Philemon-Setwaba/Embedded-Network-Performance-Monitor-for-Network-Deployments-/hardware/enclosure/images/base_dimensions.png

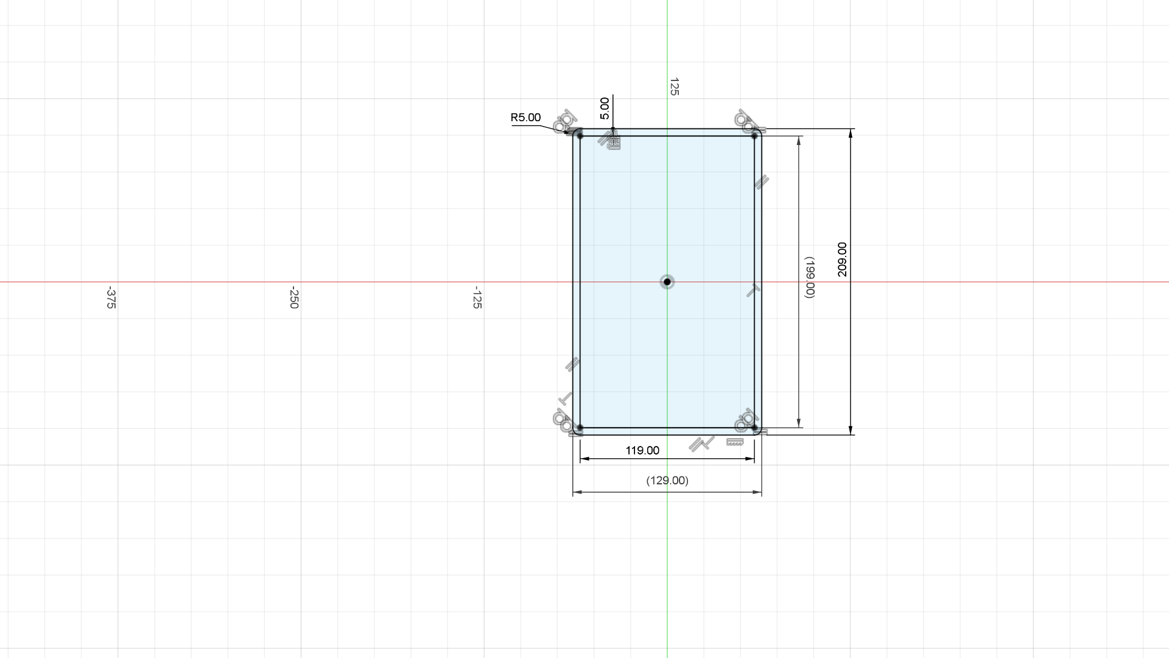
hardware/enclosure/images/base_dimensions.png
