Philemon-Setwaba/Embedded-Network-Performance-Monitor-for-Network-Deployments-/hardware/enclosure/images/base_render.png

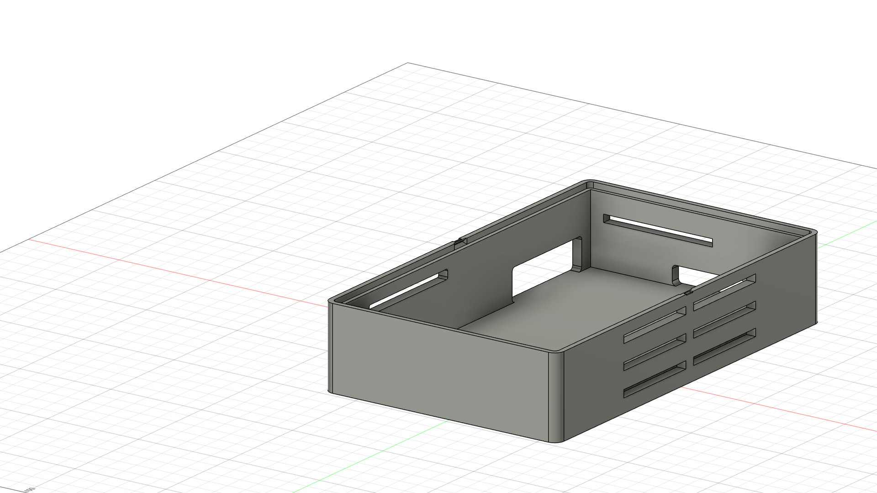
hardware/enclosure/images/base_render.png
