Philemon-Setwaba/Embedded-Network-Performance-Monitor-for-Network-Deployments-/hardware/enclosure/images/design_v0.png

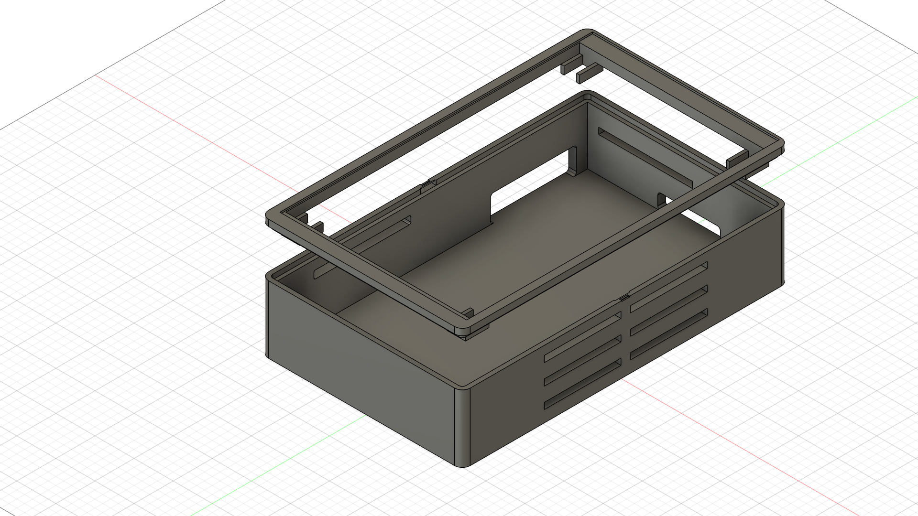
hardware/enclosure/images/design_v0.png
