Philemon-Setwaba/Embedded-Network-Performance-Monitor-for-Network-Deployments-/hardware/enclosure/images/roof_render.png

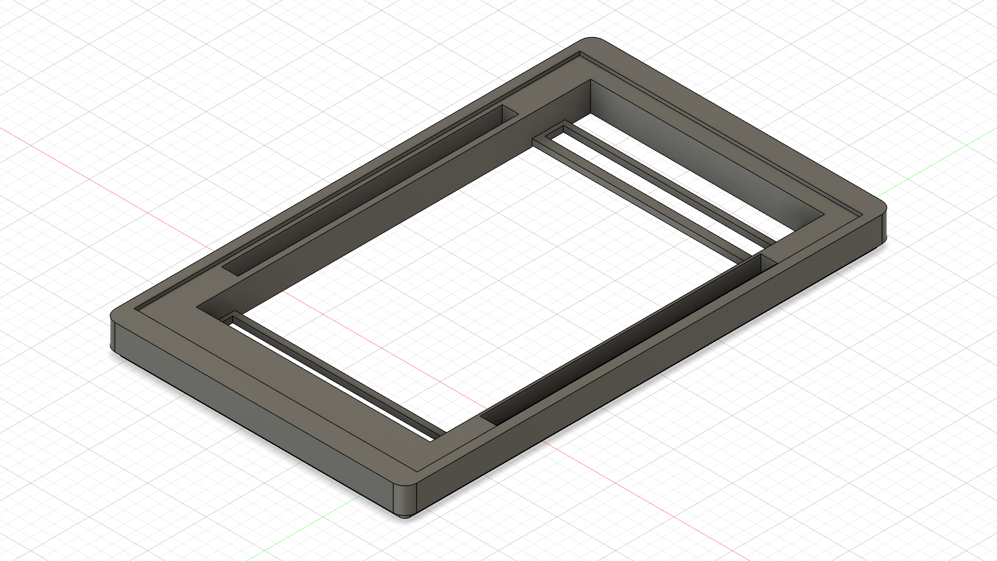
hardware/enclosure/images/roof_render.png
