Philemon-Setwaba/Embedded-Network-Performance-Monitor-for-Network-Deployments-/hardware/enclosure/images/slicer_filament.png

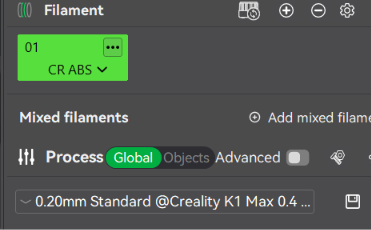
hardware/enclosure/images/slicer_filament.png
