Philemon-Setwaba/Embedded-Network-Performance-Monitor-for-Network-Deployments-/hardware/enclosure/stl/enclosure_roof.stl

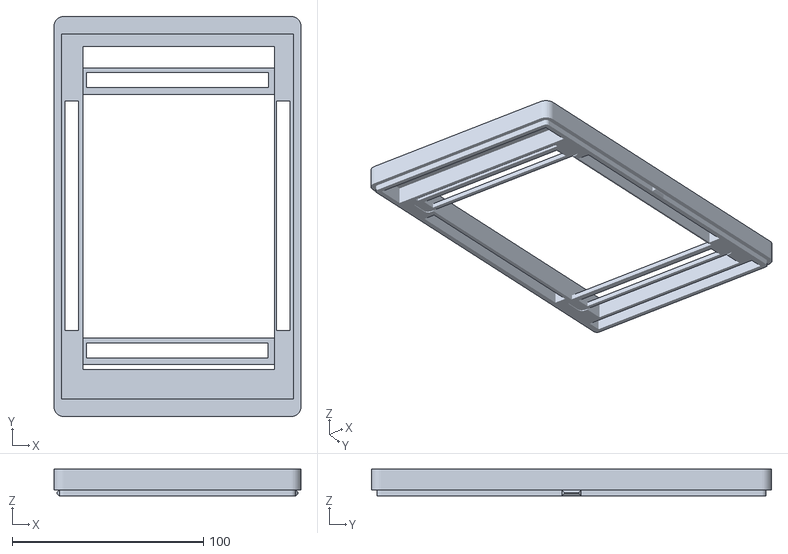
[picture p19: CAD file, 2026-11-01]
hardware/enclosure/stl/enclosure_roof.stl
129.0 x 209.0 x 14.0
