Philemon-Setwaba/Embedded-Network-Performance-Monitor-for-Network-Deployments-/hardware/enclosure/stl/enclosure_print_plate.stl

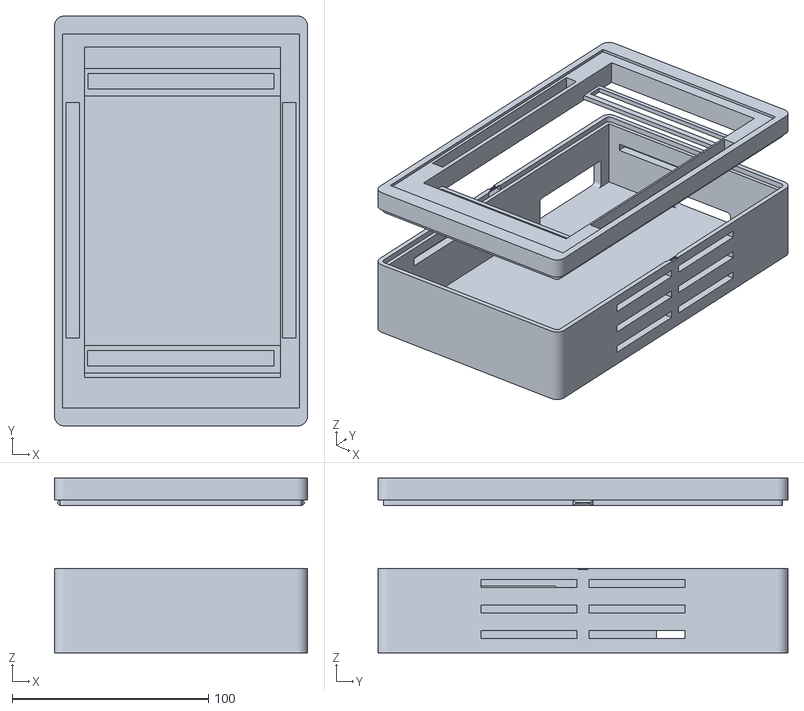
[picture p20: CAD file, 2026-11-01]
hardware/enclosure/stl/enclosure_print_plate.stl
129.0 x 209.0 x 89.0
