Philemon-Setwaba/Embedded-Network-Performance-Monitor-for-Network-Deployments-/hardware/enclosure/stl/enclosure_base.stl

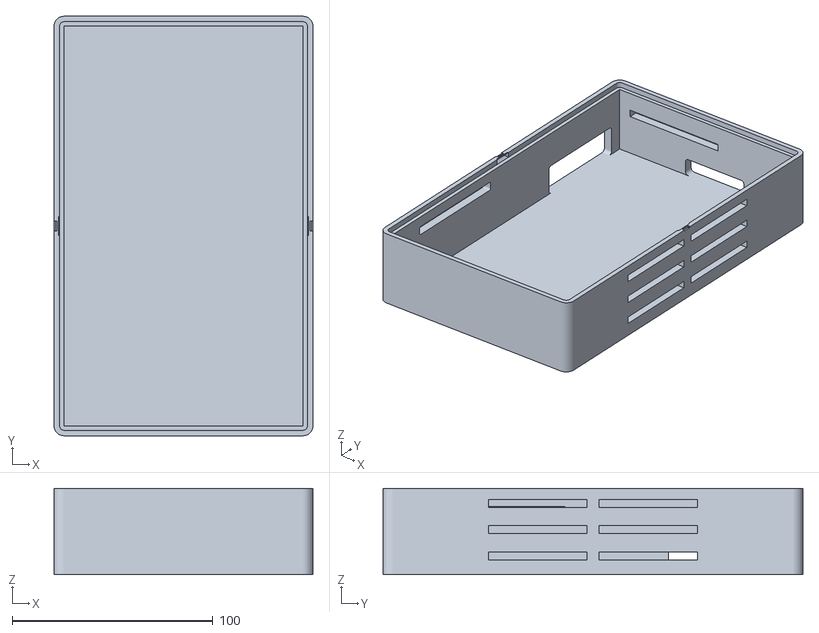
[picture p21: CAD file, 2026-11-01]
hardware/enclosure/stl/enclosure_base.stl
129.0 x 209.0 x 43.0
