Philemon-Setwaba/Embedded-Network-Performance-Monitor-for-Network-Deployments-/(list of files, cad)

Other CAD files:
hardware/enclosure/enclosure.f3d
