Philemon-Setwaba/Embedded-Network-Performance-Monitor-for-Network-Deployments-/tests/test7_normal_operation/t7_iperf.pdf

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

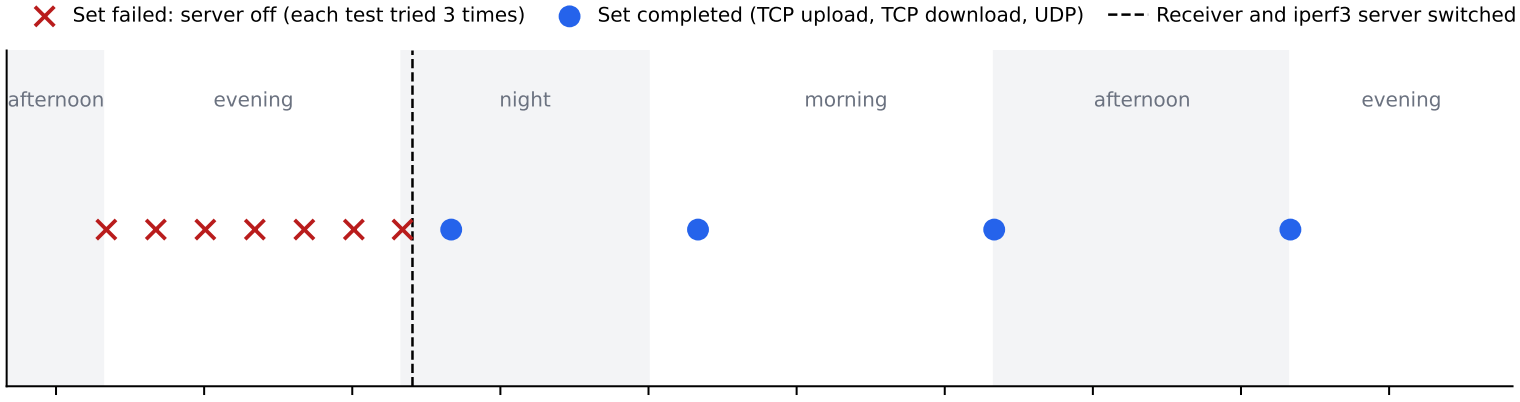
[picture p22: figure]
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
