Philemon-Setwaba/Embedded-Network-Performance-Monitor-for-Network-Deployments-/hardware/enclosure/images/printed_2.jpeg

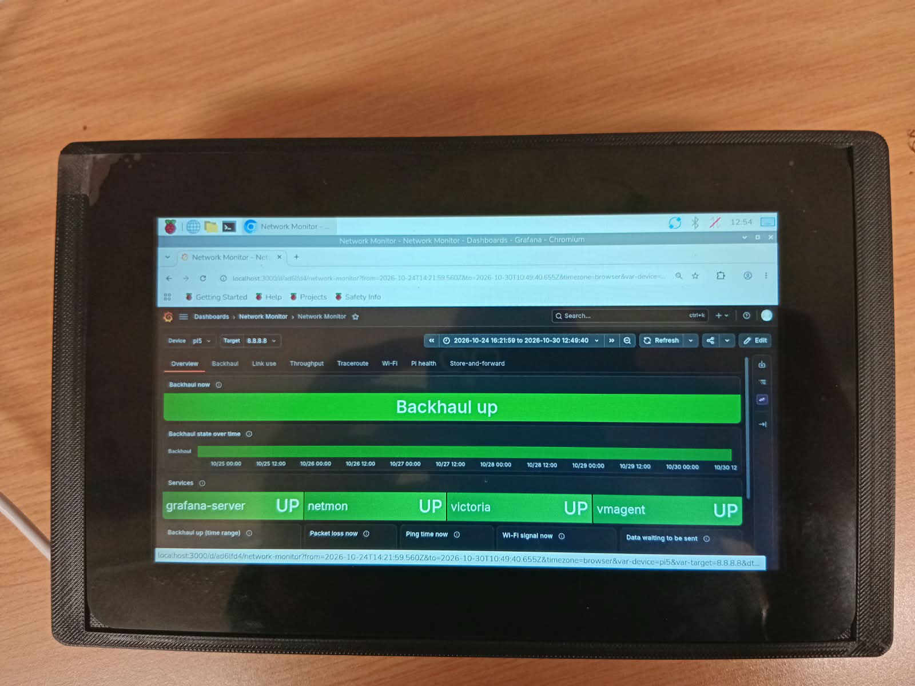
hardware/enclosure/images/printed_2.jpeg
