Philemon-Setwaba/Embedded-Network-Performance-Monitor-for-Network-Deployments-/hardware/enclosure/images/slicer_printer.png

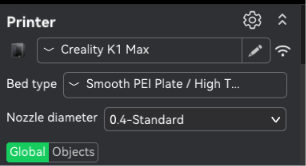
hardware/enclosure/images/slicer_printer.png
