Philemon-Setwaba/Embedded-Network-Performance-Monitor-for-Network-Deployments-/tests/test7_normal_operation/t7_iperf.png

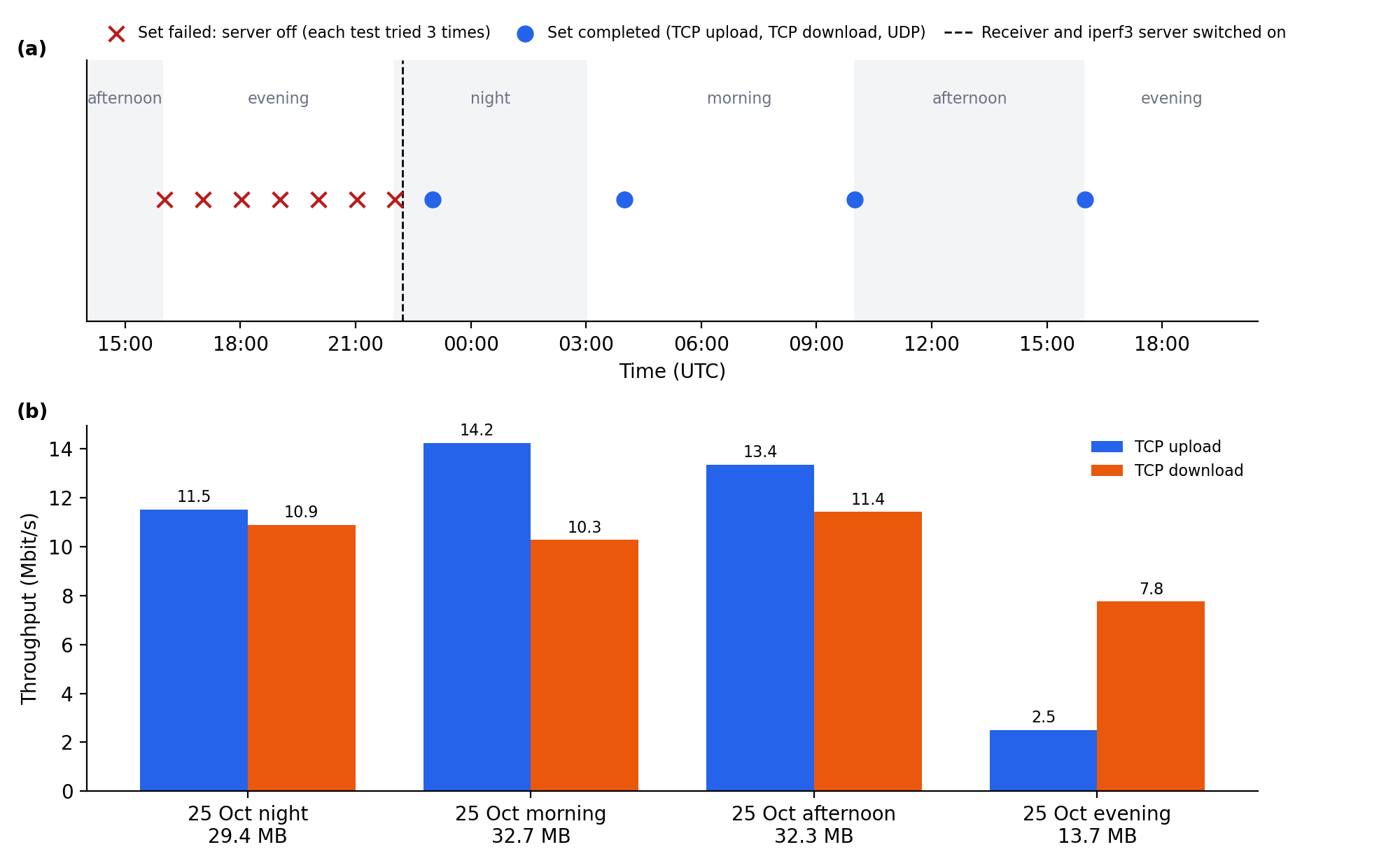
tests/test7_normal_operation/t7_iperf.png
