Philemon-Setwaba/Embedded-Network-Performance-Monitor-for-Network-Deployments-/tests/test1_packet_loss/figures/t1_backhaul_state.pdf

0 | 10 | 20 | 30 | 40 | 50 | 60 | 70 | 80

### Time since start of test (min)

0 % | 10 % | 30 % | 50 % | 70 % | 90 % | 100 % | 0 %
1 2 3 | 4 | 5 | Key
Backhaul up
Backhaul down
# | Applied loss | Down at (min) | Up at (min) | Down for (s) | Declared down because | Declared up because

1 | 90 % | 50.90 | 51.25 | 21 | 0/5 pings + TCP timeout, 2 checks in a row | 0/5 pings, but TCP connected
2 | 90 % | 51.75 | 51.94 | 11 | 0/5 pings + TCP timeout, 2 checks in a row | 1/5 pings replied
3 | 90 % | 54.98 | 55.48 | 30 | 0/5 pings + TCP timeout, 2 checks in a row | 1/5 pings replied
4 | 90 % | 59.33 | 59.75 | 25 | 0/5 pings + TCP timeout, 2 checks in a row | 0/5 pings, but TCP connected
5 | 100 % | 60.26 | 70.02 | 586 | 0/5 pings + TCP timeout, 2 checks in a row | 0/5 pings, but TCP connected

Down 5 times, 674 s in total; up for the rest of the 80 min.
Times and reasons are the state changes logged by the monitor (journal), cross-checked with the stored state samples.
