Philemon-Setwaba/Embedded-Network-Performance-Monitor-for-Network-Deployments-/tests/test2_delay/figures/t2_delay_measured_vs_applied.pdf

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

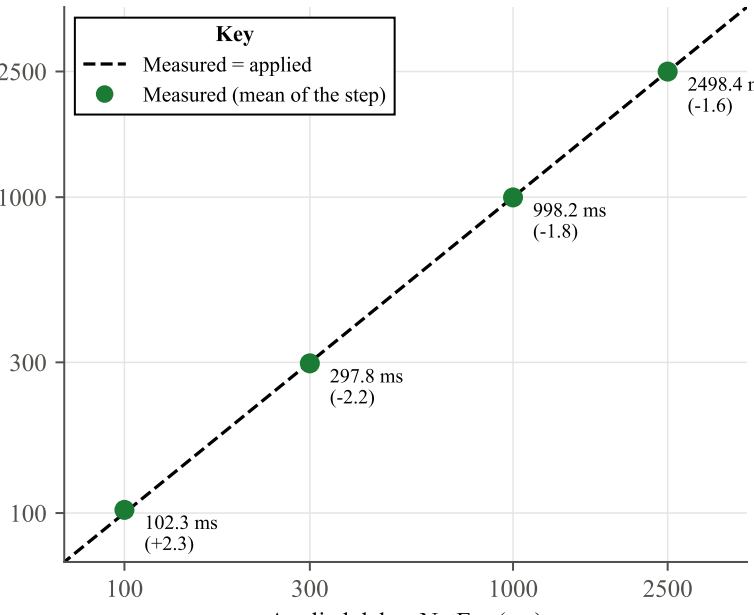
[picture p29: figure]
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
