Philemon-Setwaba/Embedded-Network-Performance-Monitor-for-Network-Deployments-/tests/test1_packet_loss/figures/t1_results_table.csv

Step | Time (min) | Applied loss | Checks | Pings | Measured loss | 95 % range | Mean RTT (ms) | Checks with all 5 lost (%) | Time reported down (%) | TCP check: connected / failed | SNMP no reply
0 (baseline) | 0–10 | 0 % | 55 | 275 | 0.4 % | 0.1–2.0 % | 77.5 | 0.0 % | 0.0 % | 0 / 0 | 0.0 %
1 | 10–20 | 10 % | 57 | 285 | 7.4 % | 4.9–11.0 % | 69.7 | 0.0 % | 0.0 % | 0 / 0 | 7.0 %
2 | 20–30 | 30 % | 57 | 285 | 27.0 % | 22.2–32.5 % | 72.4 | 0.0 % | 0.0 % | 0 / 0 | 26.3 %
3 | 30–40 | 50 % | 57 | 285 | 50.2 % | 44.4–55.9 % | 69.4 | 5.3 % | 0.0 % | 3 / 0 | 50.9 %
4 | 40–50 | 70 % | 57 | 285 | 62.8 % | 57.1–68.2 % | 78.3 | 8.8 % | 0.0 % | 3 / 2 | 64.9 %
5 | 50–60 | 90 % | 56 | 280 | 91.1 % | 87.2–93.9 % | 70.1 | 62.5 % | 14.3 % | 14 / 21 | 91.2 %
6 | 60–70 | 100 % | 57 | 285 | 100.0 % | 98.7–100.0 % | – | 100.0 % | 98.2 % | 1 / 57 | 100.0 %
7 (recovery) | 70–80 | 0 % | 57 | 285 | 0.7 % | 0.2–2.5 % | 84.9 | 0.0 % | 0.0 % | 0 / 0 | 0.0 %
