Philemon-Setwaba/Embedded-Network-Performance-Monitor-for-Network-Deployments-/tests/test2_delay/figures/t2_results_table.csv

Step | Time (min) | NetEm delay (ms) | Checks | Mean RTT (ms) | Added delay (ms) | Error (ms) | Variation per check, median (IQR) (ms) | Ping loss (%) | Time reported down | SNMP no reply
0 | 0-10 | none | 55 | 48.7 | 0.0 | 0.0 | 5.8 | 0.0 | 0.0 | 0.0
1 | 10-20 | 100 ms | 57 | 151.0 | 102.3 | 2.3 | 5.9 | 0.0 | 0.0 | 0.0
2 | 20-30 | 100 ± 10 ms | 57 | 149.1 | 100.4 | 0.4 | 8.0 | 0.0 | 0.0 | 0.0
3 | 30-40 | 100 ± 25 ms | 57 | 151.7 | 103.0 | 3.0 | 16.4 | 0.35 | 0.0 | 0.0
4 | 40-50 | 100 ± 50 ms | 57 | 152.6 | 103.9 | 3.9 | 28.7 | 0.0 | 0.0 | 0.0
5 | 50-60 | 300 ms | 57 | 346.5 | 297.8 | -2.2 | 4.4 | 0.0 | 0.0 | 0.0
6 | 60-70 | 1000 ms | 57 | 1046.9 | 998.2 | -1.8 | 5.0 | 0.0 | 0.0 | 0.0
7 | 70-80 | 2500 ms | 57 | 2547.1 | 2498.4 | -1.6 | 5.0 | 0.7 | 0.0 | 0.0
8 | 80-90 | none | 57 | 47.8 | -0.9 | -0.9 | 4.8 | 1.75 | 0.0 | 0.0
