Philemon-Setwaba/Embedded-Network-Performance-Monitor-for-Network-Deployments-/tests/test3_receiver_outage/T3/test3_outage_20261022T0423Z.csv

phase | time_utc | pending_bytes | disk_bytes | bytes_sent_total | rate_limit_reached_total | dropped | note
start | 2026-10-22T04:24:08Z |  |  |  |  |  | systemctl start vmagent
start | 2026-10-22T04:24:08Z | 0 | 57 | 0 | 0 | 0 | systemctl start netmon - outage begins (receiver off)
outage | 2026-10-22T04:25:08Z | 0 | 14848 | 0 | 0 | 0
outage | 2026-10-22T04:26:14Z | 0 | 31730 | 0 | 0 | 0
outage | 2026-10-22T04:27:19Z | 0 | 47433 | 0 | 0 | 0
outage | 2026-10-22T04:28:24Z | 0 | 64252 | 0 | 0 | 0
outage | 2026-10-22T04:29:29Z | 0 | 80165 | 0 | 0 | 0
outage | 2026-10-22T04:30:34Z | 0 | 98186 | 0 | 0 | 0
outage | 2026-10-22T04:31:39Z | 0 | 115283 | 0 | 0 | 0
outage | 2026-10-22T04:32:44Z | 0 | 133393 | 0 | 0 | 0
outage | 2026-10-22T04:33:49Z | 0 | 150400 | 0 | 0 | 0
outage | 2026-10-22T04:34:54Z | 0 | 168494 | 0 | 0 | 0
outage | 2026-10-22T04:35:59Z | 0 | 185547 | 0 | 0 | 0
outage | 2026-10-22T04:37:04Z | 0 | 203627 | 0 | 0 | 0
outage | 2026-10-22T04:38:09Z | 0 | 220726 | 0 | 0 | 0
outage | 2026-10-22T04:39:15Z | 0 | 238752 | 0 | 0 | 0
outage | 2026-10-22T04:40:20Z | 0 | 256440 | 0 | 0 | 0
outage | 2026-10-22T04:41:25Z | 0 | 274097 | 0 | 0 | 0
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
