Philemon-Setwaba/Embedded-Network-Performance-Monitor-for-Network-Deployments-/tests/test5_backhaul_outage/T6/test6_backhaul_outage_20261023T1934Z.csv

phase | time_utc | internet | router | receiver | pending_bytes | disk_bytes | bytes_sent_total | dropped | note
start | 2026-10-23T19:34:54Z |  |  |  |  |  |  |  | systemctl start vmagent
start | 2026-10-23T19:34:55Z | UP | UP | UP | 0 | 57 | 0 | 0 | systemctl start netmon - test begins
ph0_baseline | 2026-10-23T19:34:55Z | UP | UP | UP | 0 | 57 | 0 | 0 | internet_UP
ph0_baseline | 2026-10-23T19:35:05Z | UP | UP | UP | 0 | 57 | 4002 | 0
ph0_baseline | 2026-10-23T19:35:15Z | UP | UP | UP | 0 | 57 | 7335 | 0
ph0_baseline | 2026-10-23T19:35:25Z | UP | UP | UP | 0 | 57 | 9025 | 0
ph0_baseline | 2026-10-23T19:35:35Z | UP | UP | UP | 0 | 57 | 11645 | 0
ph0_baseline | 2026-10-23T19:35:45Z | UP | UP | UP | 0 | 57 | 14554 | 0
ph0_baseline | 2026-10-23T19:35:55Z | UP | UP | UP | 0 | 57 | 17871 | 0
ph0_baseline | 2026-10-23T19:36:05Z | UP | UP | UP | 0 | 57 | 19678 | 0
ph0_baseline | 2026-10-23T19:36:15Z | UP | UP | UP | 0 | 57 | 22448 | 0
ph0_baseline | 2026-10-23T19:36:25Z | UP | UP | UP | 0 | 57 | 26434 | 0
ph0_baseline | 2026-10-23T19:36:35Z | UP | UP | UP | 0 | 57 | 28388 | 0
ph0_baseline | 2026-10-23T19:36:45Z | UP | UP | UP | 0 | 57 | 30788 | 0
ph0_baseline | 2026-10-23T19:36:55Z | UP | UP | UP | 0 | 57 | 33400 | 0
ph0_baseline | 2026-10-23T19:37:05Z | UP | UP | UP | 0 | 57 | 36524 | 0
ph0_baseline | 2026-10-23T19:37:15Z | UP | UP | UP | 0 | 57 | 39556 | 0
ph0_baseline | 2026-10-23T19:37:25Z | UP | UP | UP | 0 | 57 | 41206 | 0
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
ph4_recovery2 | 2026-10-23T21:33:31Z | UP | UP | UP | 0 | 1000924 | 1915160 | 0
ph4_recovery2 | 2026-10-23T21:33:42Z | UP | UP | UP | 0 | 1000924 | 1917805 | 0
ph4_recovery2 | 2026-10-23T21:33:51Z | UP | UP | UP | 0 | 1000924 | 1920431 | 0
ph4_recovery2 | 2026-10-23T21:34:01Z | UP | UP | UP | 0 | 1000924 | 1923079 | 0
ph4_recovery2 | 2026-10-23T21:34:12Z | UP | UP | UP | 0 | 1000924 | 1925697 | 0
ph4_recovery2 | 2026-10-23T21:34:21Z | UP | UP | UP | 0 | 1000924 | 1928347 | 0
ph4_recovery2 | 2026-10-23T21:34:31Z | UP | UP | UP | 0 | 1000924 | 1930992 | 0
ph4_recovery2 | 2026-10-23T21:34:41Z | UP | UP | UP | 0 | 1000924 | 1933634 | 0
ph4_recovery2 | 2026-10-23T21:34:52Z | UP | UP | UP | 0 | 1000924 | 1936278 | 0
end | 2026-10-23T21:34:54Z | UP | UP | UP | 0 | 1000924 | 1936878 | 0 | test time over
cleanup | 2026-10-23T21:34:54Z | UP | UP | UP | 0 | 1000924 | 1936878 | 0 | systemctl stop netmon
drain | 2026-10-23T21:34:55Z | UP | UP | UP | 0 | 1000924 | 1936878 | 0 | waited_s=0
cleanup | 2026-10-23T21:34:55Z |  |  |  |  |  |  |  | systemctl stop vmagent
