Philemon-Setwaba/Embedded-Network-Performance-Monitor-for-Network-Deployments-/tests/test1_packet_loss/figures/t1_loss_timeline.png

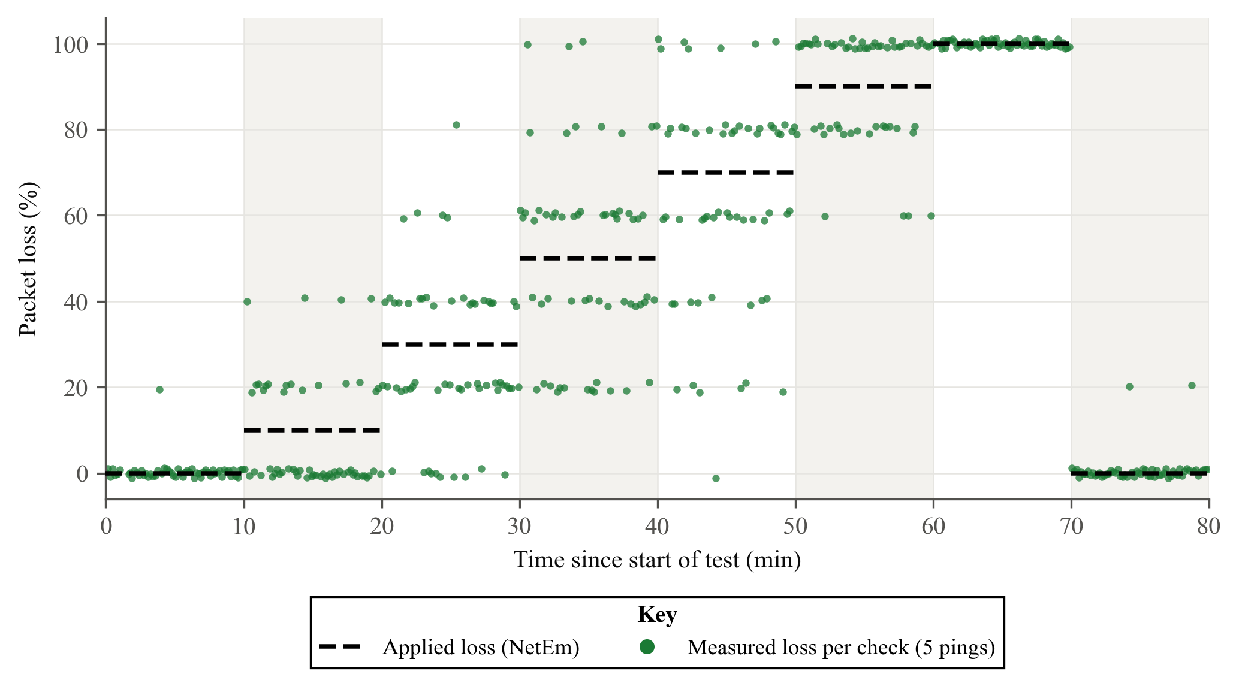
tests/test1_packet_loss/figures/t1_loss_timeline.png
