Philemon-Setwaba/Embedded-Network-Performance-Monitor-for-Network-Deployments-/tests/test1_packet_loss/Proof that it try after 1h.png

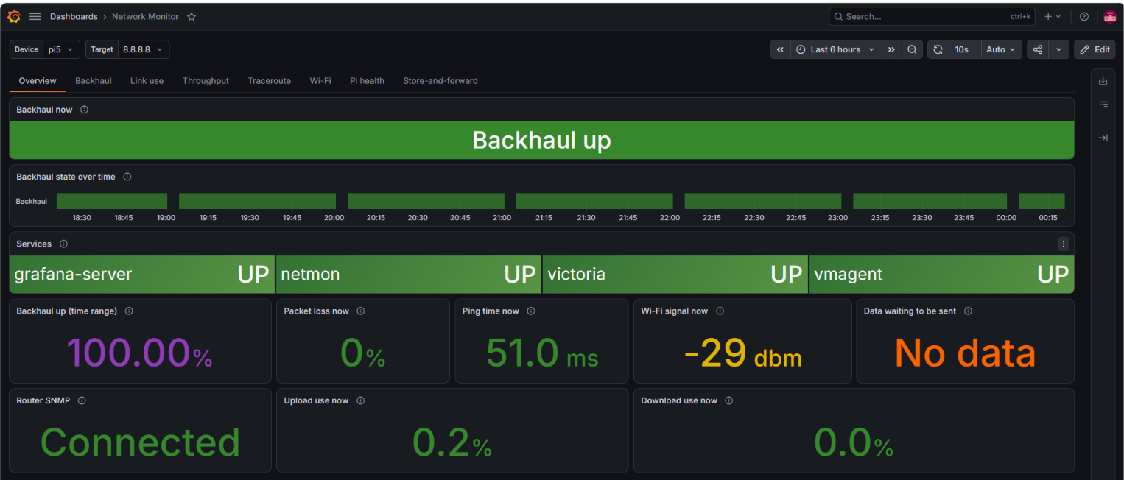
tests/test1_packet_loss/Proof that it try after 1h.png
