Philemon-Setwaba/Embedded-Network-Performance-Monitor-for-Network-Deployments-/tests/test1_packet_loss/T2.png

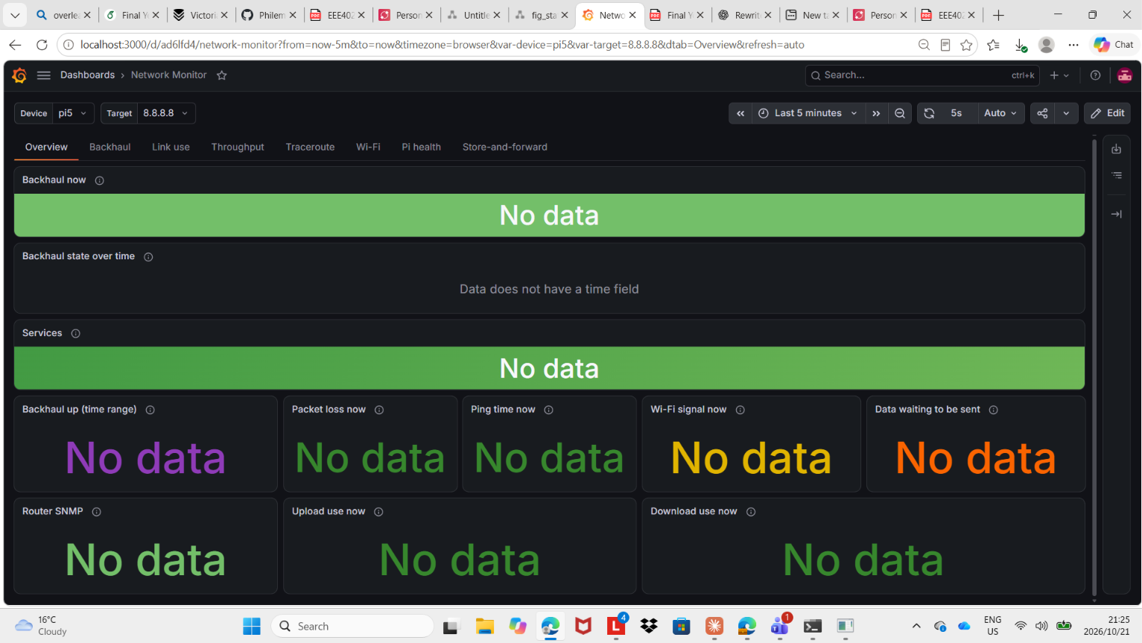
tests/test1_packet_loss/T2.png
