Philemon-Setwaba/Embedded-Network-Performance-Monitor-for-Network-Deployments-/tests/test2_delay/figures/t2_variation_measured_vs_applied.png

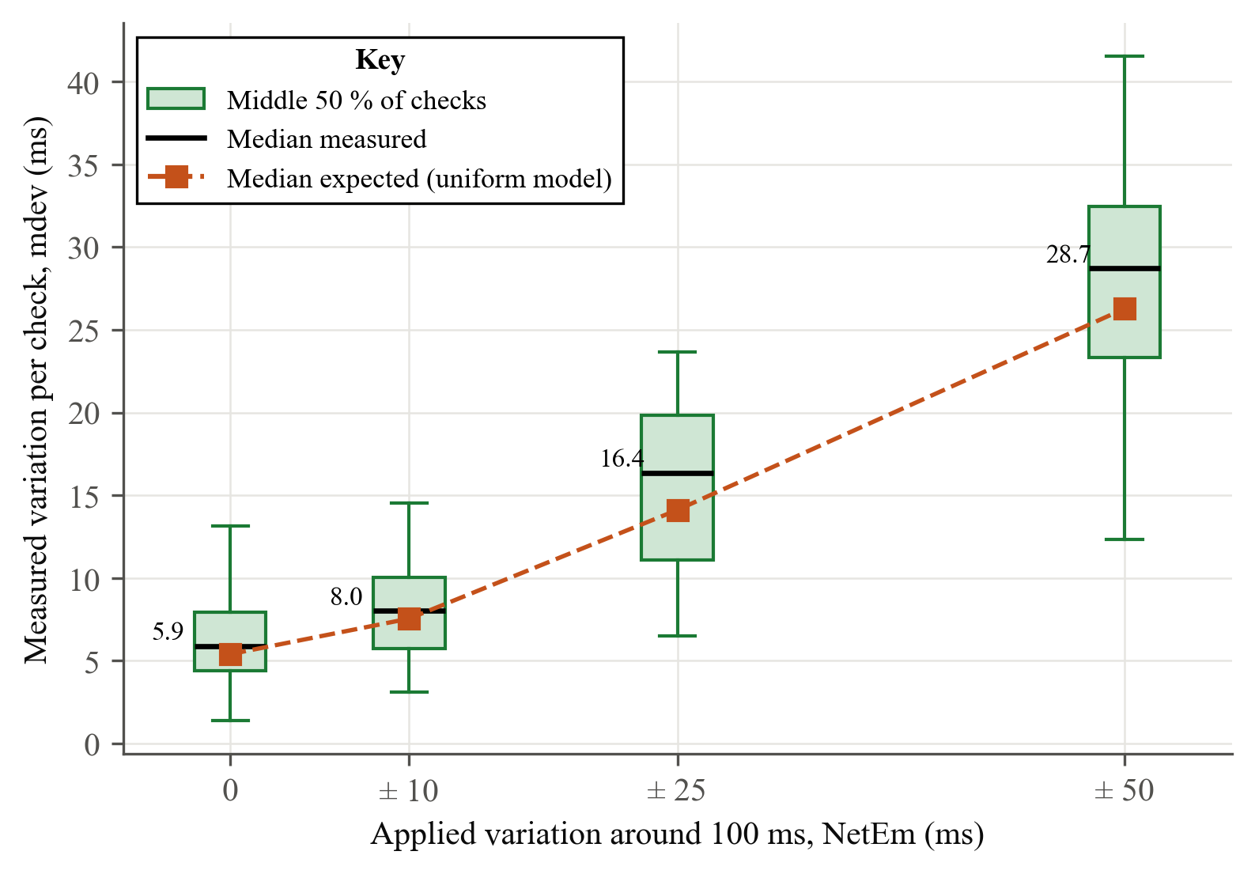
tests/test2_delay/figures/t2_variation_measured_vs_applied.png
