Philemon-Setwaba/Embedded-Network-Performance-Monitor-for-Network-Deployments-/tests/test3_receiver_outage/figures/t3_catchup.png

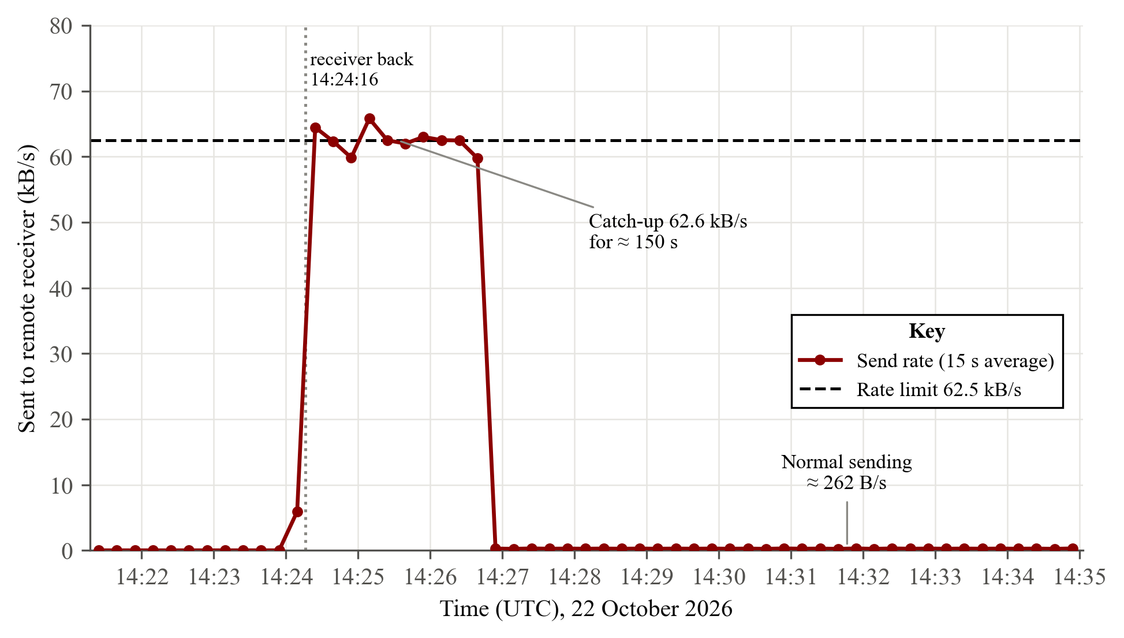
tests/test3_receiver_outage/figures/t3_catchup.png
