Philemon-Setwaba/Embedded-Network-Performance-Monitor-for-Network-Deployments-/tests/test4_snmp/first_attempt/t4_comparison_bar.png

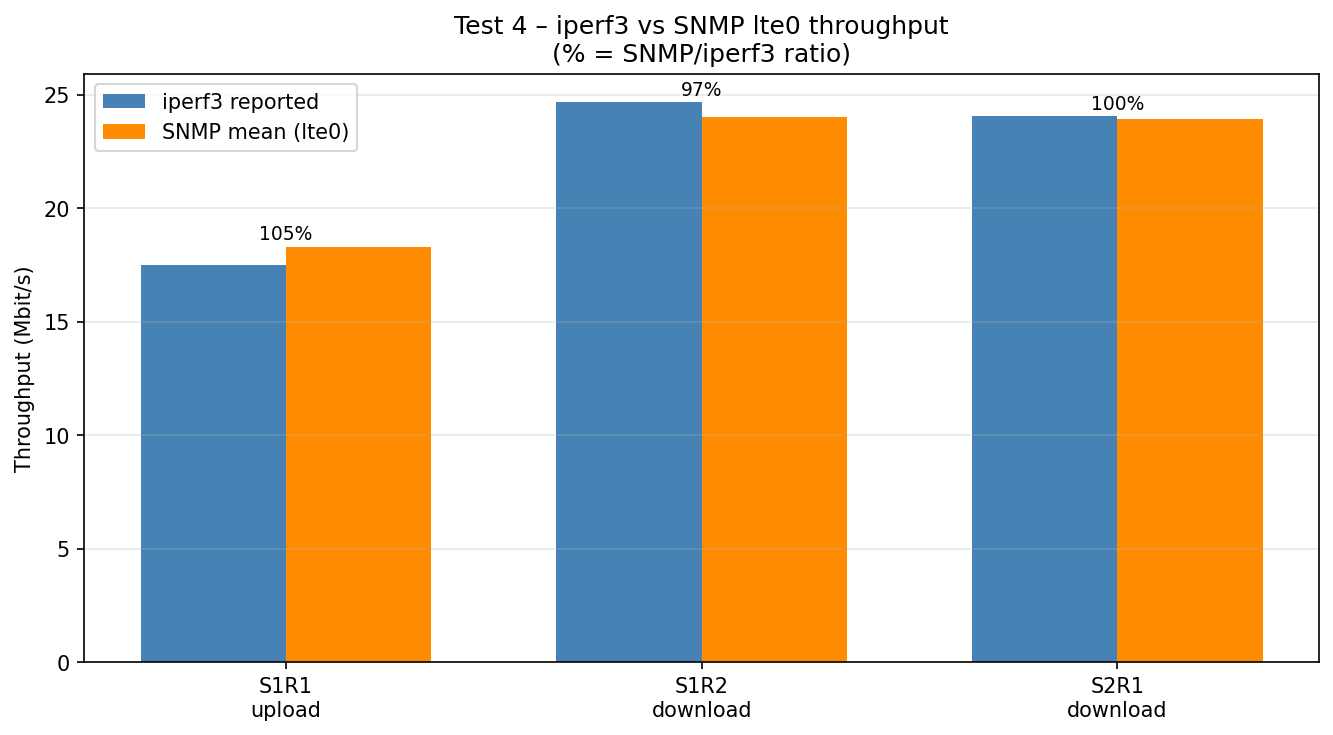
tests/test4_snmp/first_attempt/t4_comparison_bar.png
