Philemon-Setwaba/Embedded-Network-Performance-Monitor-for-Network-Deployments-/tests/test4_snmp/first_attempt/t4_snmp_validation.png

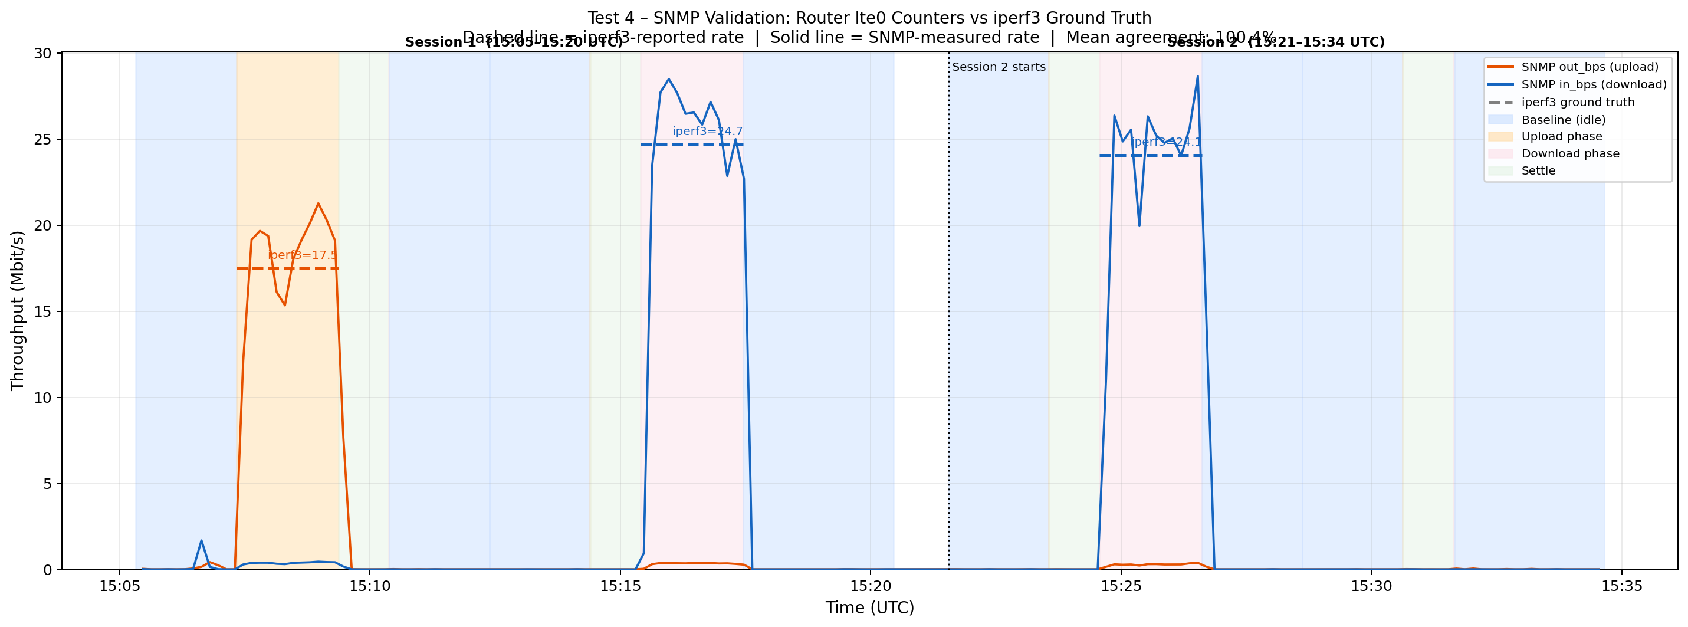
tests/test4_snmp/first_attempt/t4_snmp_validation.png
