Philemon-Setwaba/Embedded-Network-Performance-Monitor-for-Network-Deployments-/tests/test4_snmp/t4_fig1_timeline.png

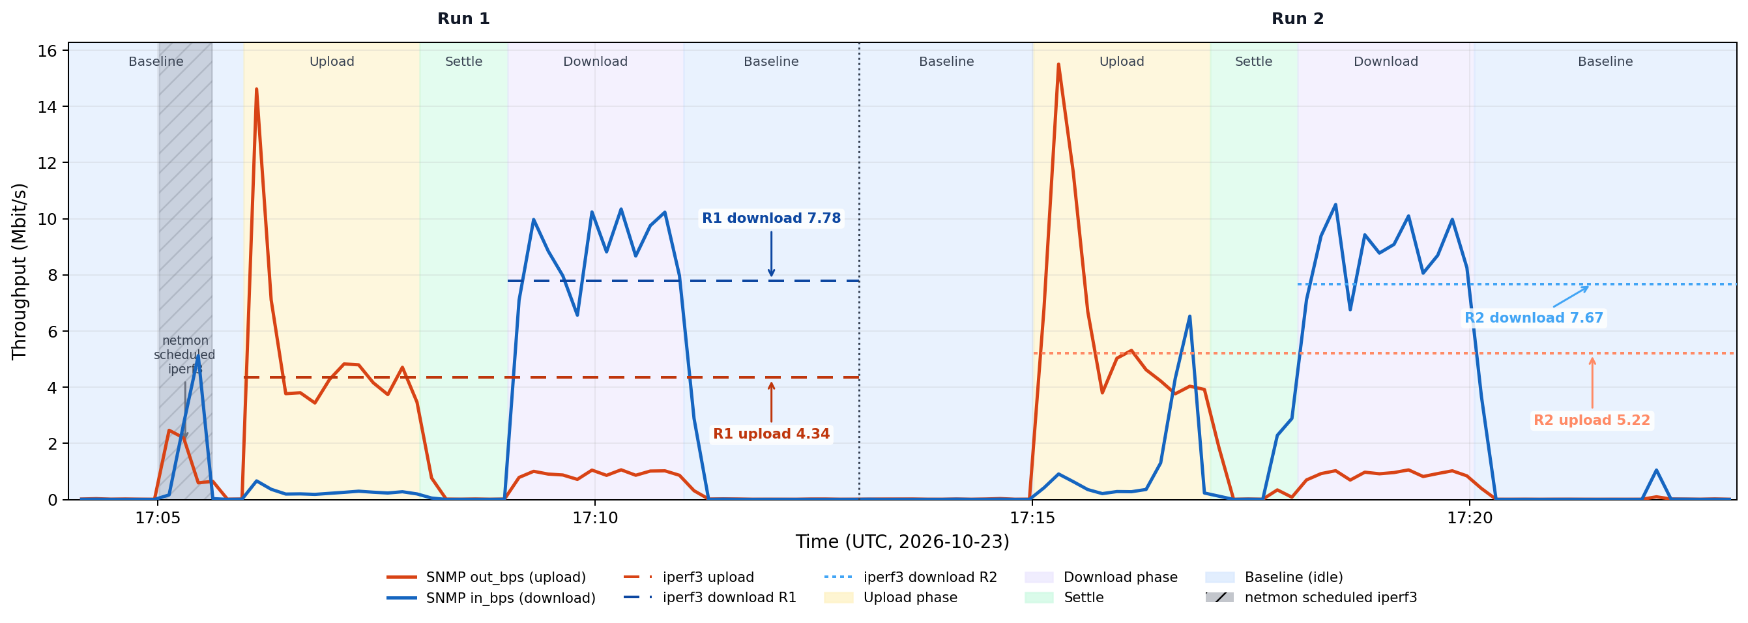
tests/test4_snmp/t4_fig1_timeline.png
