Philemon-Setwaba/Embedded-Network-Performance-Monitor-for-Network-Deployments-/tests/test4_snmp/t4_fig2_comparison.png

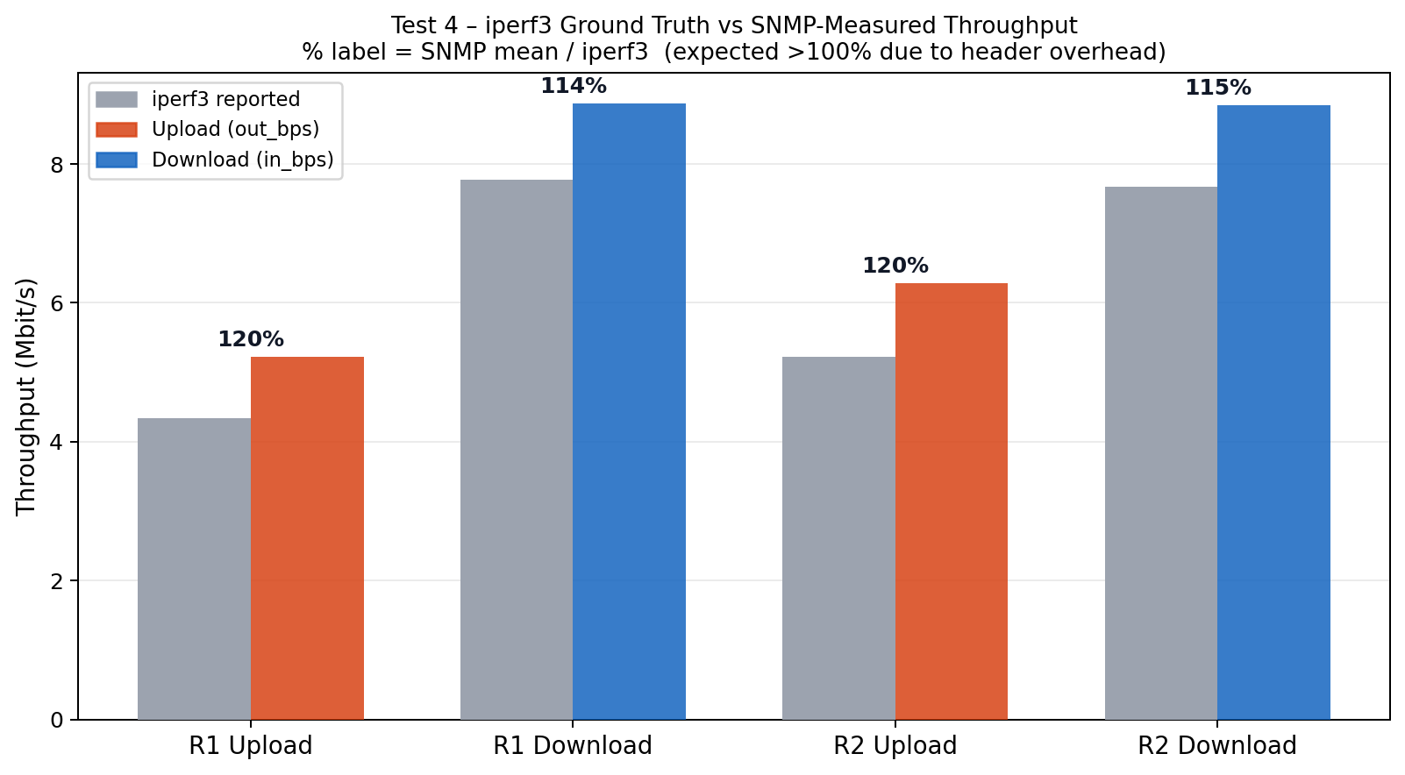
tests/test4_snmp/t4_fig2_comparison.png
