Philemon-Setwaba/Embedded-Network-Performance-Monitor-for-Network-Deployments-/tests/test5_backhaul_outage/t5_backhaul_outage.png

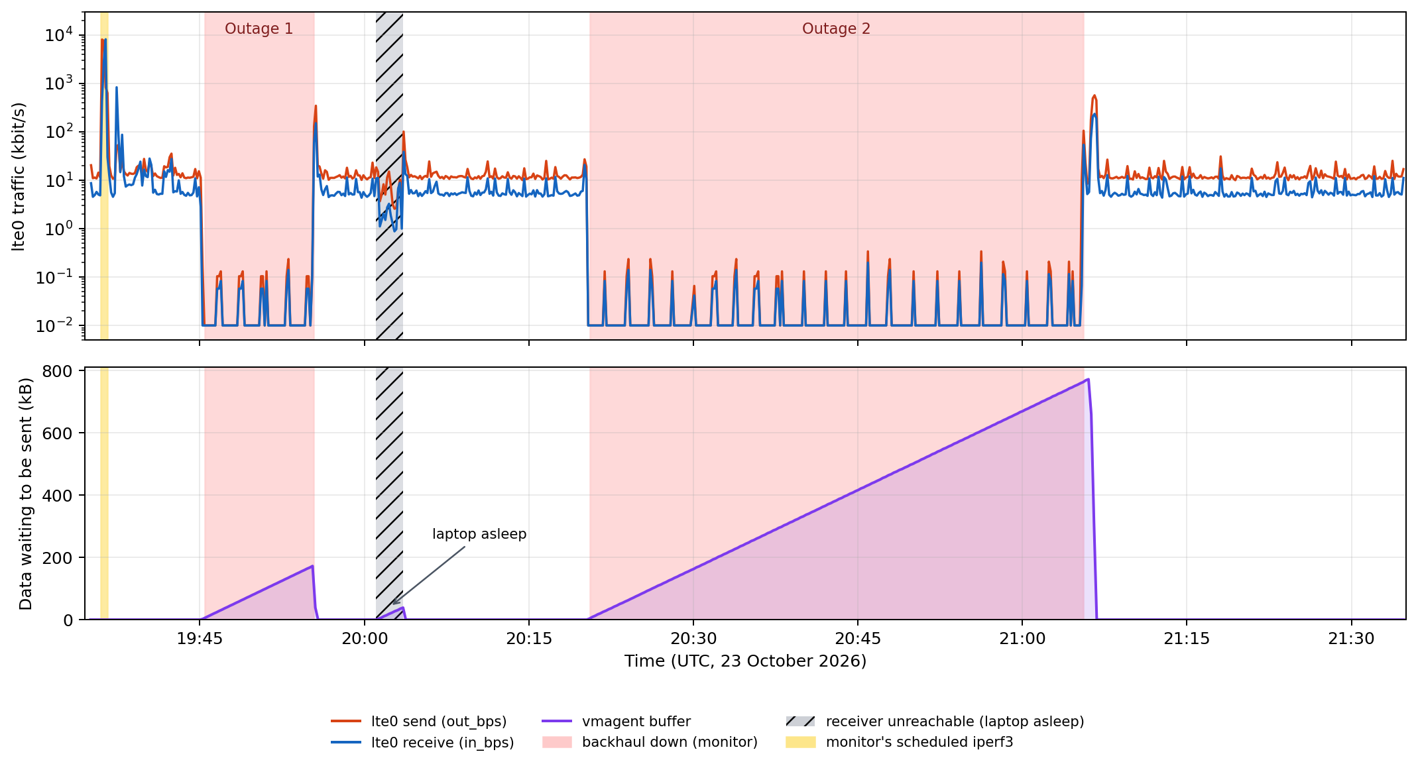
tests/test5_backhaul_outage/t5_backhaul_outage.png
