Philemon-Setwaba/Embedded-Network-Performance-Monitor-for-Network-Deployments-/tests/test6_power_cut/t6_resources.png

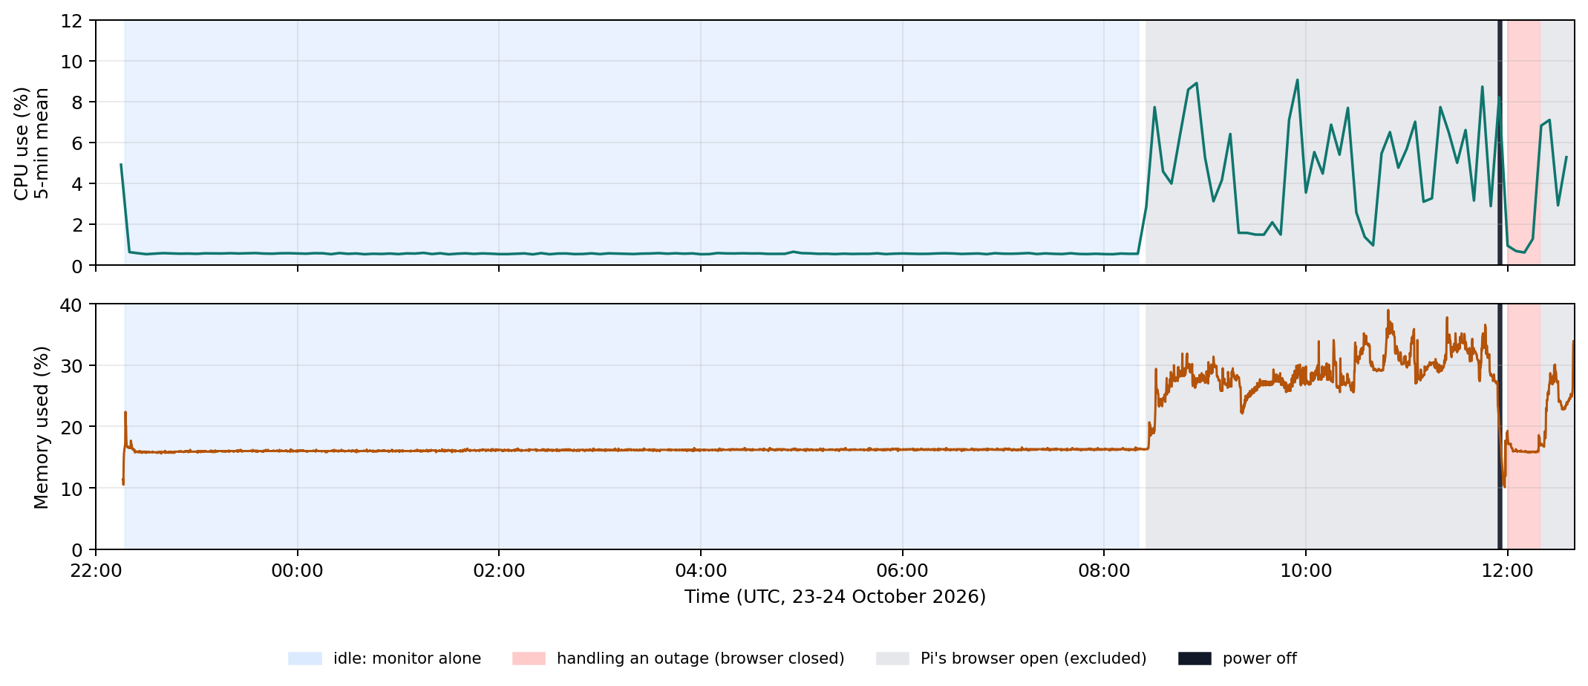
tests/test6_power_cut/t6_resources.png
