Philemon-Setwaba/Embedded-Network-Performance-Monitor-for-Network-Deployments-/tests/test6_power_cut/T7/idle/screenshots/2026traceroute.png

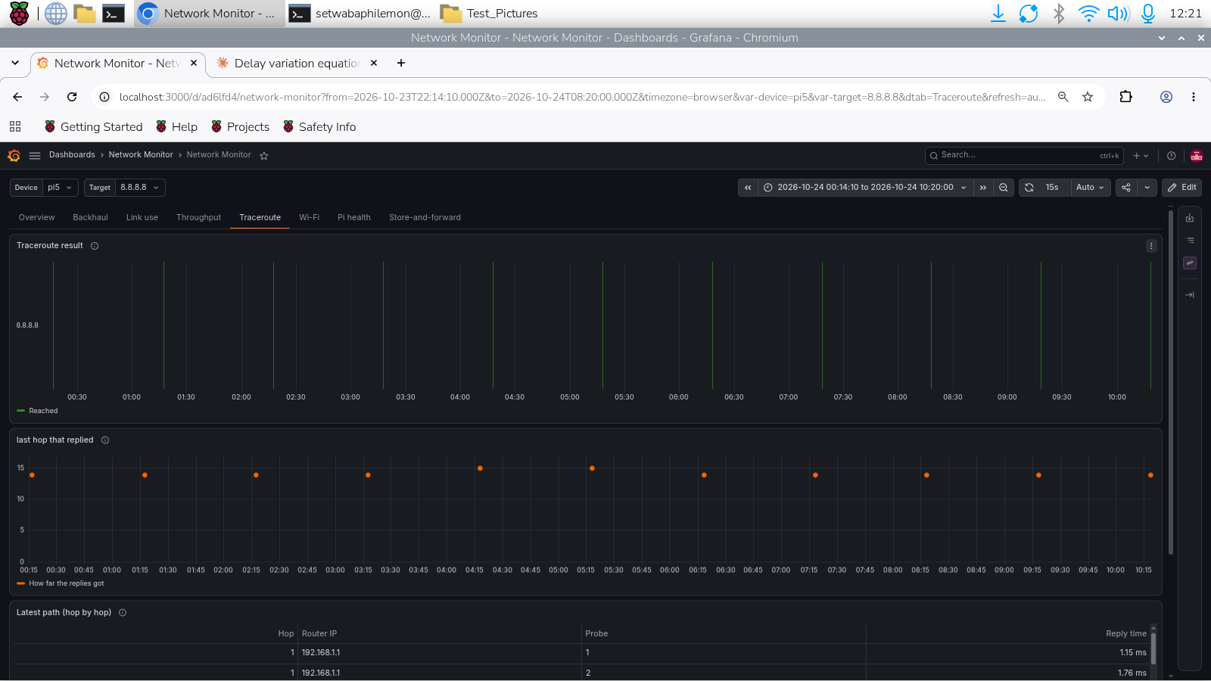
tests/test6_power_cut/T7/idle/screenshots/2026traceroute.png
