Philemon-Setwaba/Embedded-Network-Performance-Monitor-for-Network-Deployments-/tests/test4_snmp/t4_fig1_timeline.pdf

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

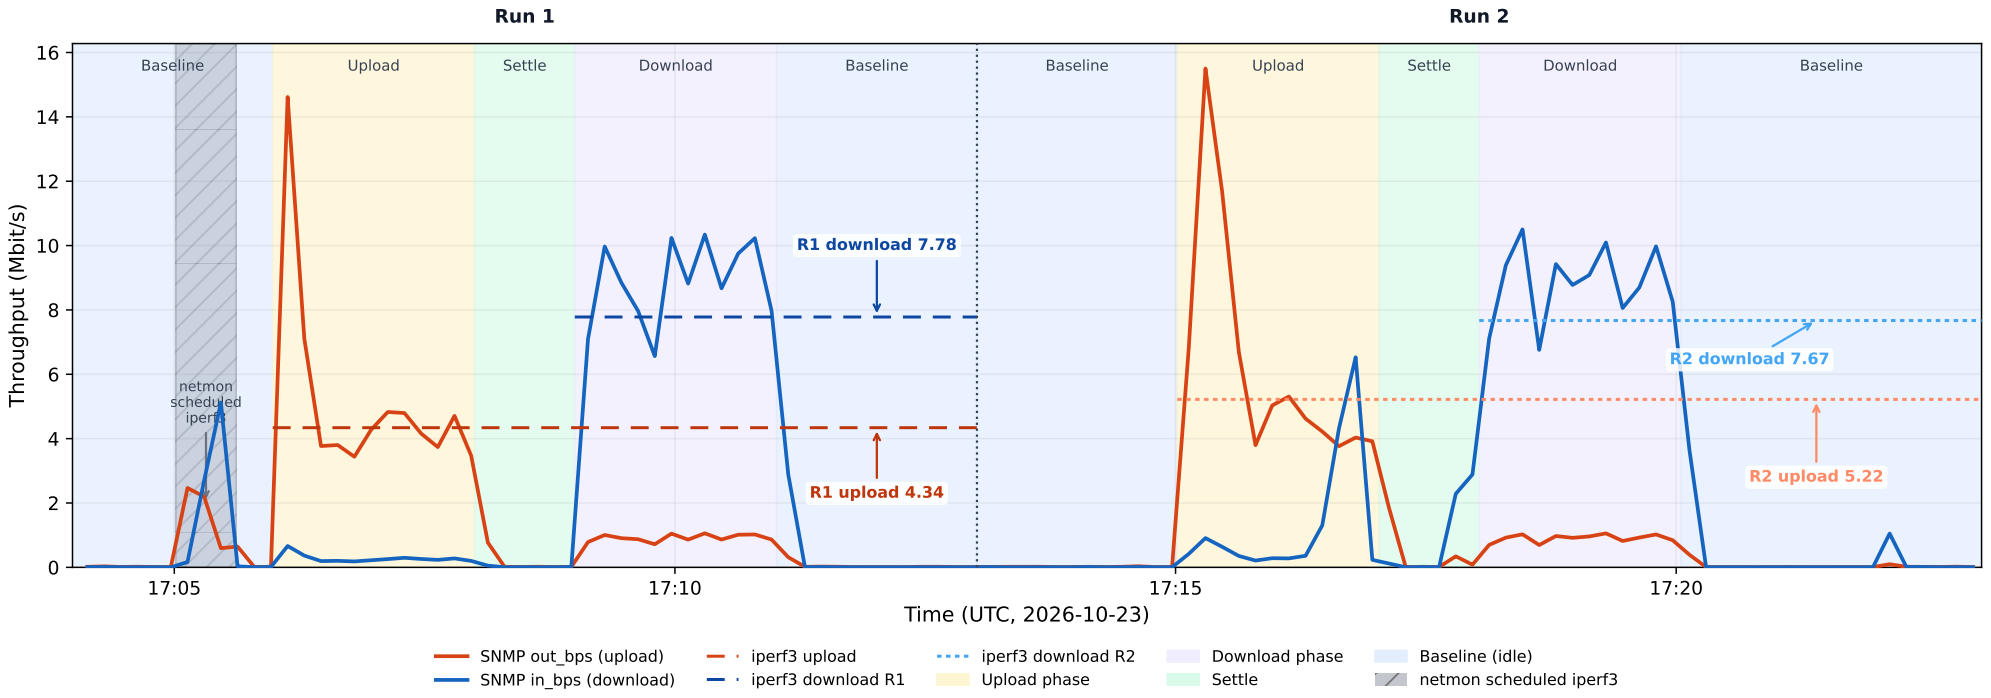
[picture p58: page 1]
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
