Philemon-Setwaba/Embedded-Network-Performance-Monitor-for-Network-Deployments-/tests/test5_backhaul_outage/t5_backhaul_outage.pdf

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

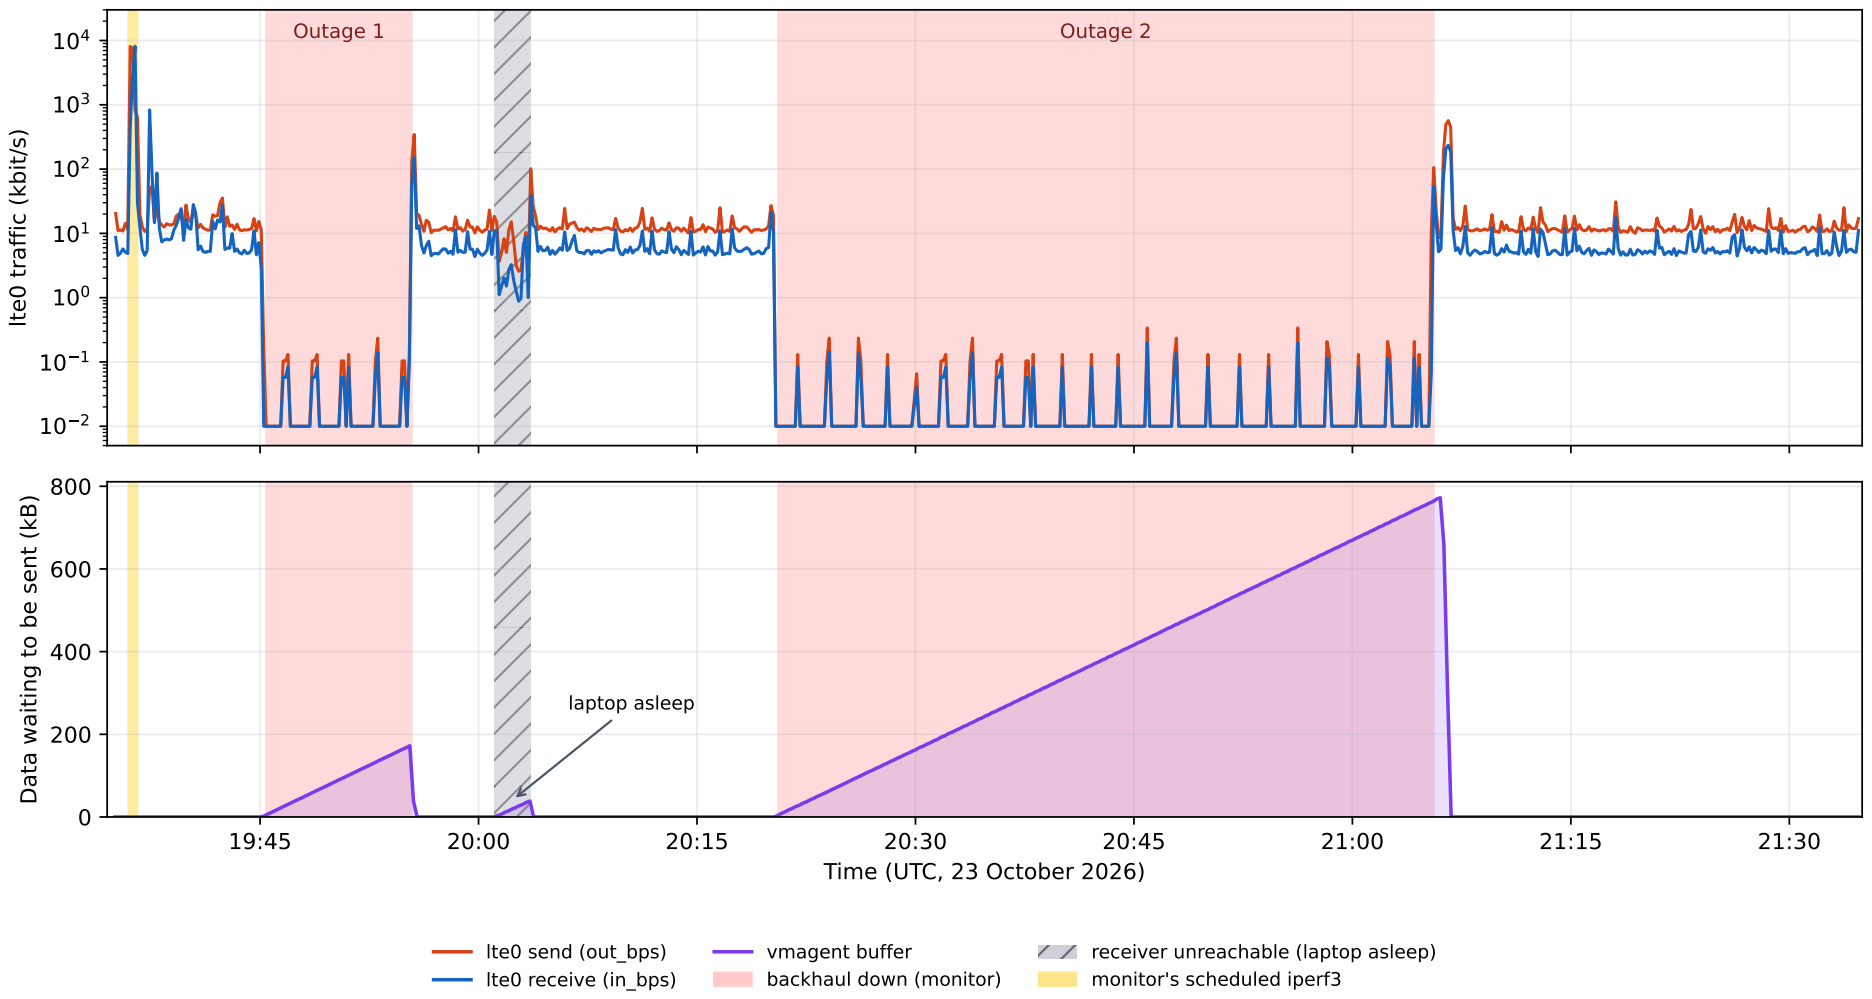
[picture p59: page 1]
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
