Philemon-Setwaba/Embedded-Network-Performance-Monitor-for-Network-Deployments-/tests/test1_packet_loss/figures/t1_loss_timeline.pdf

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

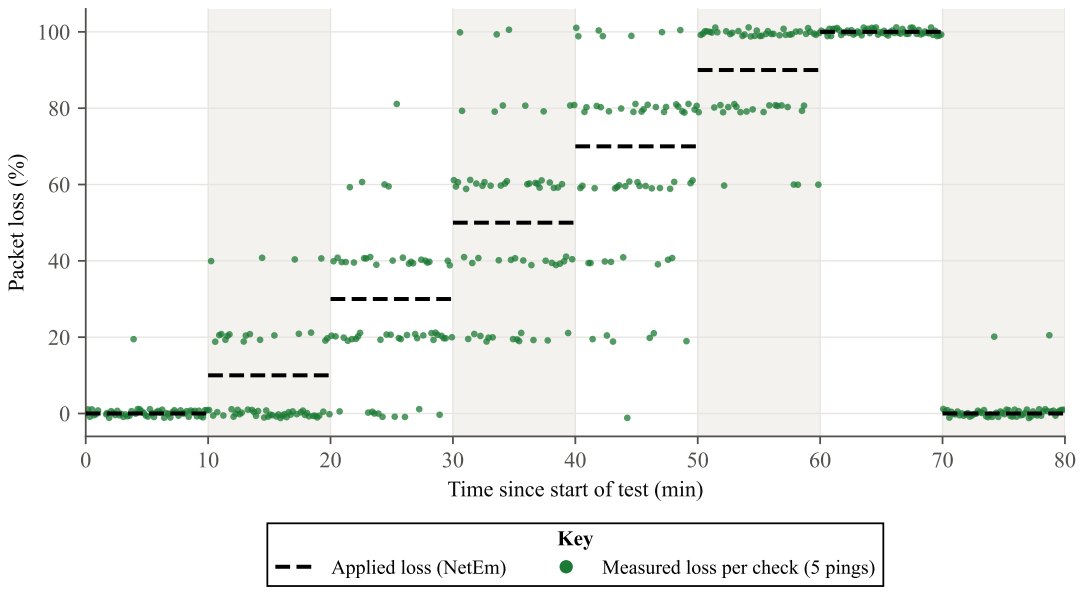
[picture p64: page 1]
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
