Philemon-Setwaba/Embedded-Network-Performance-Monitor-for-Network-Deployments-/tests/test3_receiver_outage/figures/t3_buffer_growth.pdf

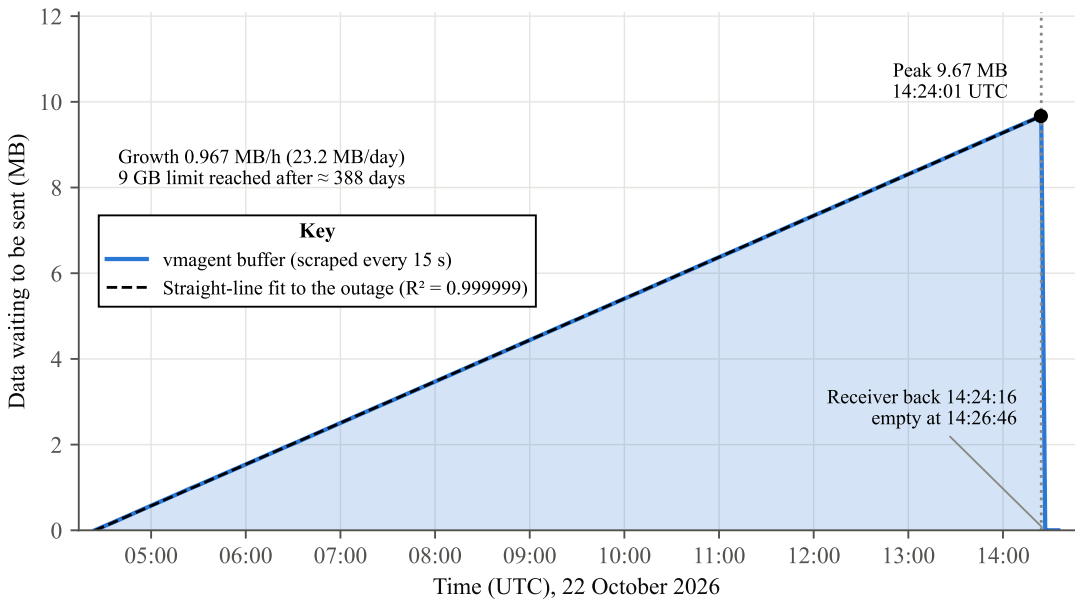
[picture p68: page 1]
Peak 9.67 MB 14:24:01 UTC; Receiver back 14:24:16 empty at 14:26:46; Key

Data waiting to be sent (MB)

Growth 0.967 MB/h (23.2 MB/day)
9 GB limit reached after 388 days

vmagent buffer (scraped every 15 s)
Straight-line fit to the outage (R² = 0.999999)

Time (UTC), 22 October 2026
