Philemon-Setwaba/Embedded-Network-Performance-Monitor-for-Network-Deployments-/tests/test3_receiver_outage/figures/t3_catchup.pdf

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

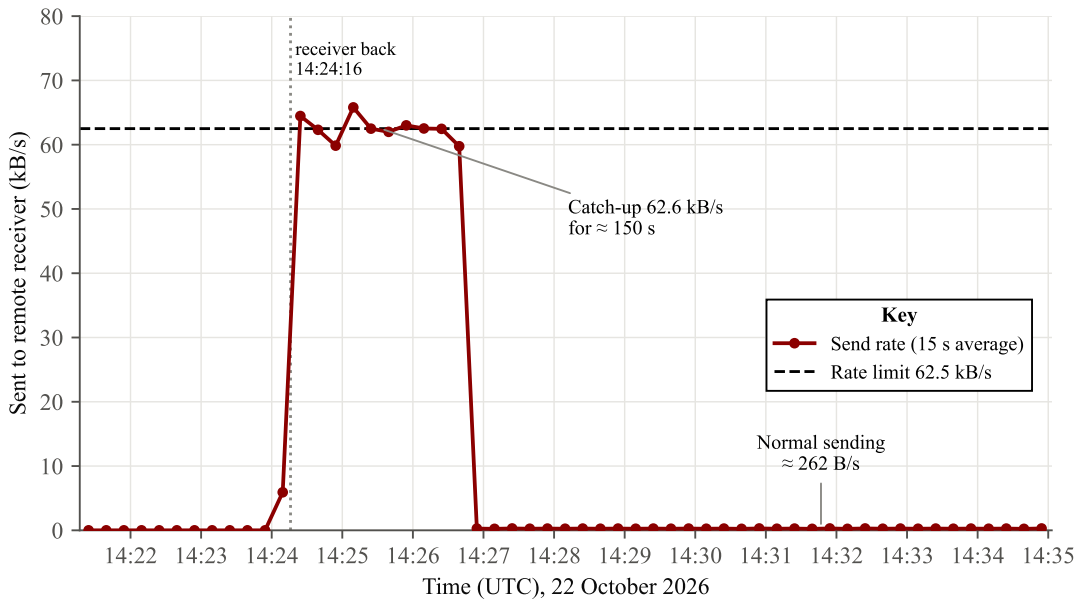
[picture p69: page 1]
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
