Philemon-Setwaba/Embedded-Network-Performance-Monitor-for-Network-Deployments-/(commit log)

2026-09-15 Add Raspberry Pi setup script for SNMP monitoring
2026-09-27 Add traceroute measurement module (every probe, last responding hop)
2026-10-01 traceroute: return a message instead of crashing if traceroute is missing
2026-10-07 Add system health measurement (power, thermal, load, storage, services)
2026-10-08 traceroute: parse hops into TracerouteResult, add traceroute_lines.py
2026-10-08 fixed traceroute to show blocked status
2026-10-08 traceroute_lines: last_reply_info shows the target when it was reached
2026-10-09 scheduler.py: two lanes (passive + active threads); add ping job
2026-10-11 traceroute: wait 2 s per probe (-w 2): worst case 30 s -> 12 s measured
2026-10-11 traceroute_job: run on down, every 30 min while down, on back up, hourly baseline
2026-10-11 scheduler: add traceroute job to the active lane after state
2026-10-11 traceroute: mark from the Pi own IP = local_unreachable, not blocked
2026-10-11 traceroute_lines: add status 4 = local_unreachable
2026-10-11 config: add traceroute section (8.8.8.8, 30 min while down, 1 h baseline)
2026-10-11 scheduler: add iperf job to the active lane after traceroute
2026-10-11 iperf_job: one set (TCP up, TCP down, UDP) per slot - night, morning, afternoon, evening
2026-10-11 iperf_job: remember done slots and last tries in data/iperf_state.json across restarts
2026-10-13 grafana: throughput, traceroute and wi-fi tabs (restored from versions)
2026-10-13 grafana: restore dashboard from db copy 02:46 - 29 panels (throughput, traceroute, wi-fi)
2026-10-30 Add test folders (scripts, data, notebooks, figures), tests README and dashboard screenshots
    [t1_results_table.csv, t2_results_table.csv, test1_loss_20261021T1834Z.csv, test2_delay_20261021T2350Z.csv, test3_outage_20261022T0423Z.csv, test4_snmp_validation_20261023T1505Z.csv, test4_snmp_validation_20261023T1521Z.csv, test4_snmp_validation_20261023T1703Z.csv]
2026-11-01 Add enclosure design (Fusion 360, STL, drawings, photos) with README and CC BY-NC licence
    [enclosure.f3d, enclosure_base.stl, enclosure_print_plate.stl, enclosure_roof.stl]
2026-11-09 README: folder links, test scripts, Test 6 result, enclosure licence, Grafana install
2026-11-11 Enclosure: add Touch Display 2 reference images (Raspberry Pi Ltd)
